ShiroFPV/ShiroFPV_Flight_Controller_Collection/V1_30x30_SFVPF435/Shematic/ShiroFPV_Flight_Controller.kicad_pcb

## KiCad design V1_30x30_SFVPF435/Shematic/ShiroFPV_Flight_Controller.kicad_pcb (2026-06-26)

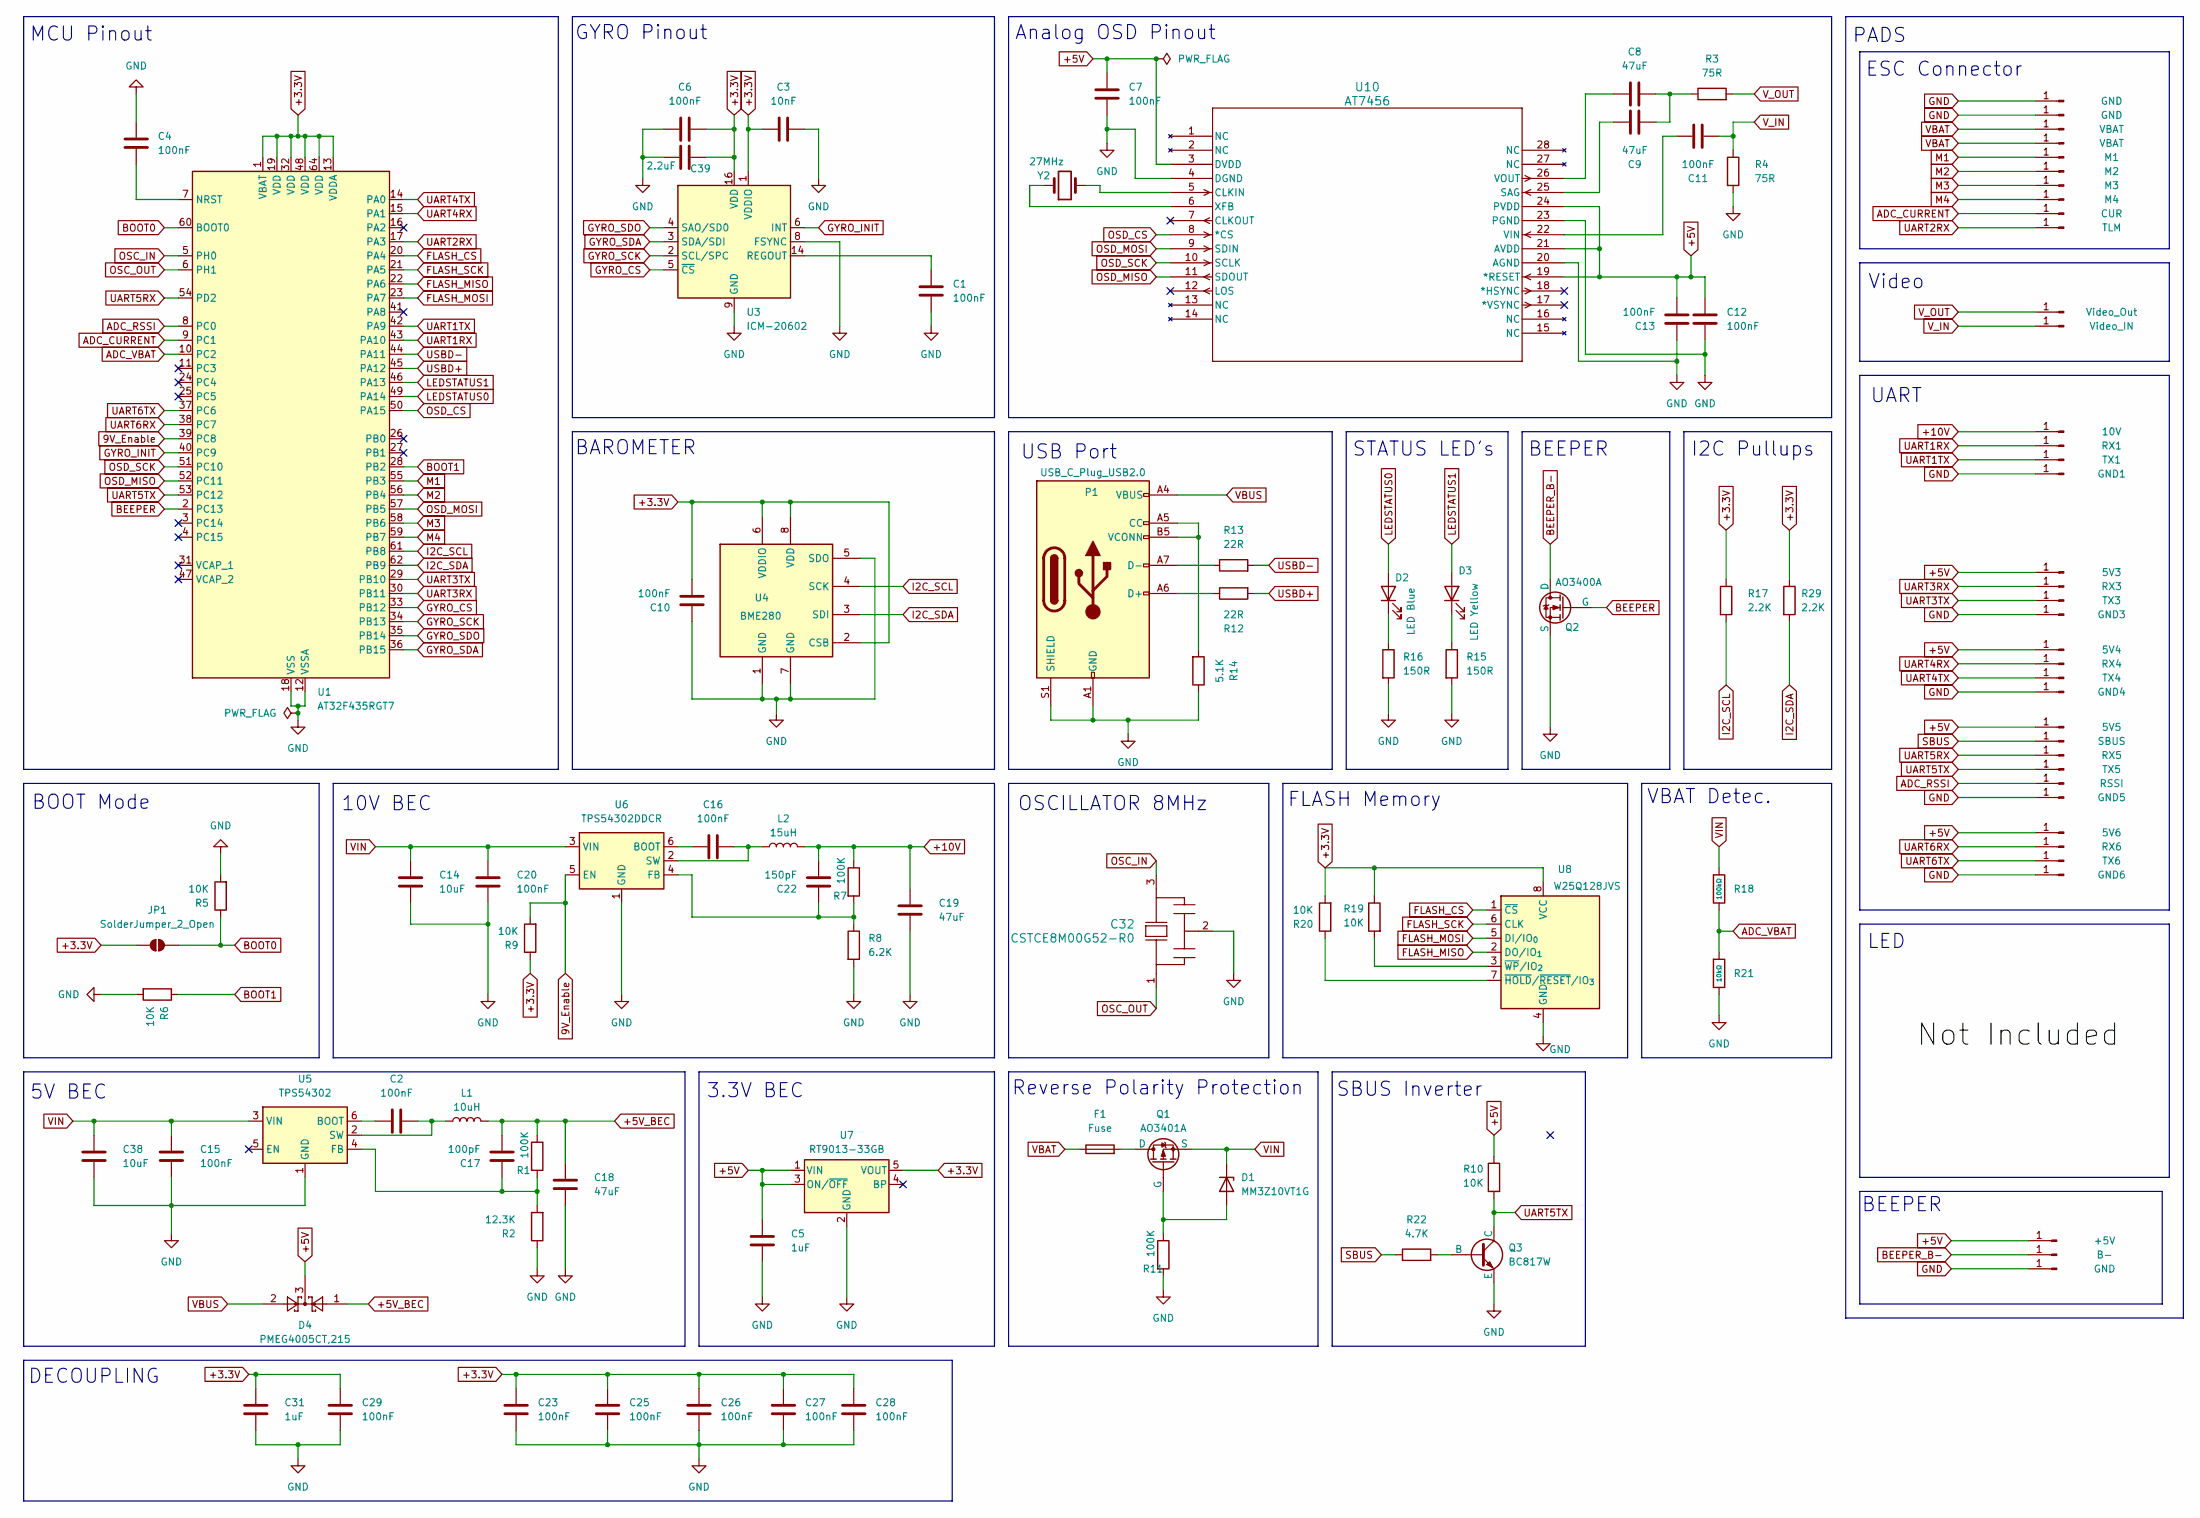
[picture p1: schematic ShiroFPV_Flight_Controller.kicad_sch, AT435 Flight Controller]

Parts:
C1, C2, C4, C6, C7, C10, C11, C12, C13, C15, C16, C20, C23, C25, C26, C27, C28, C29: 100nF; C_0603_1608Metric; MPN CC0603JRX7R8BB104
C3: 10nF; C_0603_1608Metric; MPN C0603C103F3GECAUTO
C5, C31: 1uF; C_0603_1608Metric; MPN 1uF_0603_X7R_16V
C8, C9: 47uF; C_0603_1608Metric; MPN GRM31CR61E476ME44L
C14, C38: 10uF; C_1206_3216Metric; MPN CL31B106KBHNNNE
C17: 100pF; C_0603_1608Metric; MPN CC0603JRX7R9BB101
C18, C19: 47uF; C_1206_3216Metric; MPN GRM31CR61E476ME44L
C22: 150pF; C_0603_1608Metric; MPN CC0603JRX7R9BB151
C32: CSTCE8M00G52-R0; 8MHz-Osciallator.kicad_sym; MPN CSTNE8M00G520000R0
C39: 2.2uF; C_0603_1608Metric; MPN CC0603KRX5R6BB225
D1: MM3Z10VT1G; D_SOD-323_HandSoldering; MPN LM3Z10VT1G
D2: LED Blue; LED_0603_1608Metric
D3: LED Yellow; LED_0603_1608Metric
D4: PMEG4005CT,215; SOT-23
F1: Fuse; Fuse_1206_3216Metric
J1, J2, J46: GND; TestPoint_Pad_1.0x1.0mm
J3, J4: VBAT; TestPoint_Pad_1.0x1.0mm
J5: M1; TestPoint_Pad_1.0x1.0mm
J6: M2; TestPoint_Pad_1.0x1.0mm
J7: M3; TestPoint_Pad_1.0x1.0mm
J8: M4; TestPoint_Pad_1.0x1.0mm
J9: CUR; TestPoint_Pad_1.0x1.0mm
J10: TLM; TestPoint_Pad_1.0x1.0mm
J11: Video_Out; TestPoint_Pad_1.0x1.0mm
J12: Video_IN; TestPoint_Pad_1.0x1.0mm
J13: 5V3; TestPoint_Pad_1.0x1.0mm
J14: RX3; TestPoint_Pad_1.0x1.0mm
J15: TX3; TestPoint_Pad_1.0x1.0mm
J16: GND3; TestPoint_Pad_1.0x1.0mm
J17: 5V4; TestPoint_Pad_1.0x1.0mm
J18: RX4; TestPoint_Pad_1.0x1.0mm
J19: TX4; TestPoint_Pad_1.0x1.0mm
J20: GND4; TestPoint_Pad_1.0x1.0mm
J24: +5V; TestPoint_Pad_1.0x1.0mm
J25: RSSI; TestPoint_Pad_1.0x1.0mm
J26: GND5; TestPoint_Pad_1.0x1.0mm
J29: SBUS; TestPoint_Pad_1.0x1.0mm
J30: 5V5; TestPoint_Pad_1.0x1.0mm
J31: RX5; TestPoint_Pad_1.0x1.0mm
J32: TX5; TestPoint_Pad_1.0x1.0mm
J33: RX6; TestPoint_Pad_1.0x1.0mm
J34: 5V6; TestPoint_Pad_1.0x1.0mm
J35: GND6; TestPoint_Pad_1.0x1.0mm
J36: TX6; TestPoint_Pad_1.0x1.0mm
J37: 10V; TestPoint_Pad_1.0x1.0mm
J38: RX1; TestPoint_Pad_1.0x1.0mm
J39: TX1; TestPoint_Pad_1.0x1.0mm
J40: GND1; TestPoint_Pad_1.0x1.0mm
J42: B-; TestPoint_Pad_1.0x1.0mm
JP1: SolderJumper_2_Open; SolderJumper-2_P1.3mm_Open_Pad1.0x1.5mm
L1: 10uH; L_APV_APH0412
L2: 15uH; L_APV_APH0412; MPN YSPI0530-150M
P1: USB_C_Plug_USB2.0; USB_C_Receptacle_G-Switch_GT-USB-7010ASV; MPN GT-USB-7010ASV
Q1: AO3401A; SOT-23
Q2: AO3400A; SOT-23
Q3: BC817W; SOT-323_SC-70
R1, R7, R11: 100K; R_0603_1608Metric; MPN RC0603FR-07100KL
R2: 12.3K; R_0603_1608Metric; MPN RC0603FR-0712K3L
R3, R4: 75R; R_0603_1608Metric; MPN RC0603FR-0775RL
R5, R6, R9, R10, R19, R20: 10K; R_0603_1608Metric; MPN RC0603FR-0710KL
R8: 6.2K; R_0603_1608Metric; MPN RC0603FR-076K2L
R12, R13: 22R; R_0603_1608Metric; MPN RC0603FR-0722RL
R14: 5.1K; R_0603_1608Metric; MPN RC0603FR-075K1L
R15, R16: 150R; R_0603_1608Metric; MPN RC0603FR-07150RL
R17, R29: 2.2K; R_0603_1608Metric; MPN RC0603FR-072K2L
R18: 100kΩ; R_0603; Overload Voltage (Max) 75V; Tolerance ±1%; Part 0603WAF1003T5E; LCSC C25803
R21: 10kΩ; R_0603; Overload Voltage (Max) 75V; Tolerance ±1%; Part 0603WAF1002T5E; LCSC C25804
R22: 4.7K; R_0603_1608Metric; MPN RC0603FR-074K7L
U1: AT32F435RGT7; LQFP-64_10x10mm_P0.5mm
U3: ICM-20602; LGA-16_3x3mm_P0.5mm_LayoutBorder3x5y; MPN ICM-20602
U4: BME280; Bosch_LGA-8_2.5x2.5mm_P0.65mm_ClockwisePinNumbering; MPN BME280
U5: TPS54302; SOT-23-6; MPN TPS54302DDCR
U6: TPS54302DDCR; SOT-23-6; MPN TPS54302DDCR
U7: RT9013-33GB; SOT-23-5; MPN RT9013-33GB
U8: W25Q128JVS; SOIC-8_5.3x5.3mm_P1.27mm; MPN W25Q128JVSIQ
U10: AT7456; MPN AT7456E
Y2: 27MHz; Crystal_SMD_3225-4Pin_3.2x2.5mm

Connections:
9V_Enable: R9.2, U1.39 (PC8), U6.5 (EN)
+3.3V: C3.1, C6.2, C10.1, C23.1, C25.1, C26.1, C27.1, C28.1, C29.1, C31.1, C39.1, JP1.1 (A), R9.1, R17.1, R19.1, R20.2, R29.1, U1.1 (VBAT), U1.13 (VDDA), U1.19 (VDD), U1.32 (VDD), U1.48 (VDD), U1.64 (VDD), U3.1 (VDDIO), U3.16 (VDD), U4.2 (CSB), U4.6 (VDDIO), U4.8 (VDD), U7.5 (VOUT), U8.8 (VCC)
+5V: C5.1, C7.2, C12.2, C13.1, D4.3, J13.1 (Pin_1_1), J17.1 (Pin_1_1), J24.1 (Pin_1_1), J30.1 (Pin_1_1), J34.1 (Pin_1_1), R10.1, U7.1 (VIN), U7.3 (ON/~OFF), U10.3 (DVDD), U10.19 (*RESET), U10.21 (AVDD), U10.24 (PVDD)
+5V_BEC: C17.1, C18.1, D4.1, L1.2, R1.1
+10V: C19.1, C22.1, J37.1 (Pin_1_1), L2.2, R7.1
ADC_CURRENT: J9.1 (Pin_1_1), U1.9 (PC1)
ADC_RSSI: J25.1 (Pin_1_1), U1.8 (PC0)
ADC_VBAT: R18.2, R21.1, U1.10 (PC2); also elsewhere on the board
BEEPER: Q2.2 (G), U1.2 (PC13)
BEEPER_B-: J42.1 (Pin_1_1), Q2.1 (D)
BOOT0: JP1.2 (B), R5.1, U1.60 (BOOT0)
BOOT1: R6.1, U1.28 (PB2)
FLASH_CS: U1.20 (PA4), U8.1 (~CS)
FLASH_MISO: U1.22 (PA6), U8.2 (DO/IO_{1})
FLASH_MOSI: U1.23 (PA7), U8.5 (DI/IO_{0})
FLASH_SCK: U1.21 (PA5), U8.6 (CLK)
GND: C1.1, C3.2, C4.1, C5.2, C6.1, C7.1, C10.2, C12.1, C13.2, C14.2, C15.2, C18.2, C19.2, C20.2, C23.2, C25.2, C26.2, C27.2, C28.2, C29.2, C31.2, C32.2, C38.2, C39.2, J1.1 (Pin_1_1), J2.1 (Pin_1_1), J16.1 (Pin_1_1), J20.1 (Pin_1_1), J26.1 (Pin_1_1), J35.1 (Pin_1_1), J40.1 (Pin_1_1), J46.1 (Pin_1_1), P1.A1 (GND), P1.A12 (GND), P1.B1 (GND), P1.B12 (GND), P1.S1 (SHIELD), Q2.3 (S), Q3.3 (E), R2.1, R4.2, R5.2, R6.2, R8.2, R11.2, R14.1, R15.2, R16.2, R21.2, U1.12 (VSSA), U1.18 (VSS), U1.63 (VSS), U3.8 (FSYNC), U3.9 (GND), U3.10 (GND), U3.11 (GND), U3.12 (GND), U3.13 (GND), U3.15 (GND), U4.1 (GND), U4.5 (SDO), U4.7 (GND), U5.1 (GND), U6.1 (GND), U7.2 (GND), U8.4 (GND), U10.4 (DGND), U10.20 (AGND), U10.23 (PGND), Y2.3, Y2.4
GYRO_CS: U1.33 (PB12), U3.5 (~CS)
GYRO_INIT: U1.40 (PC9), U3.6 (INT)
GYRO_SCK: U1.34 (PB13), U3.2 (SCL/SPC)
GYRO_SDA: U1.36 (PB15), U3.3 (SDA/SDI)
GYRO_SDO: U1.35 (PB14), U3.4 (SAO/SD0)
I2C_SCL: R17.2, U1.61 (PB8), U4.4 (SCK)
I2C_SDA: R29.2, U1.62 (PB9), U4.3 (SDI)
LEDSTATUS0: D2.2 (A), U1.49 (PA14)
LEDSTATUS1: D3.2 (A), U1.46 (PA13)
M1: J5.1 (Pin_1_1), U1.55 (PB3)
M2: J6.1 (Pin_1_1), U1.56 (PB4)
M3: J7.1 (Pin_1_1), U1.58 (PB6)
M4: J8.1 (Pin_1_1), U1.59 (PB7)
unnamed: C8.2, C9.2, R3.1
unnamed: D1.2 (A), Q1.2 (G), R11.1
unnamed: D2.1 (K), R16.1
unnamed: D3.1 (K), R15.1
unnamed: P1.A5 (CC), P1.B5 (VCONN), R14.2
unnamed: P1.A6 (D+), R12.1
unnamed: P1.A7 (D-), R13.1
unnamed: F1.2, Q1.1 (D)
unnamed: Q3.2 (B), R22.2
unnamed: C4.2, U1.7 (NRST)
unnamed: C1.2, U3.14 (REGOUT)
unnamed: C2.2, U5.6 (BOOT)
unnamed: C17.2, R1.2, R2.2, U5.4 (FB)
unnamed: C2.1, L1.1, U5.2 (SW)
unnamed: C16.2, U6.6 (BOOT)
unnamed: C22.2, R7.2, R8.1, U6.4 (FB)
unnamed: C16.1, L2.1, U6.2 (SW)
unnamed: R20.1, U8.7 (~HOLD/~RESET/IO_{3})
unnamed: R19.2, U8.3 (~WP/IO_{2})
unnamed: U10.5 (CLKIN), Y2.2
unnamed: C9.1, U10.25 (SAG)
unnamed: C11.1, U10.22 (VIN)
unnamed: C8.1, U10.26 (VOUT)
unnamed: U10.6 (XFB), Y2.1
OSC_IN: C32.3, U1.5 (PH0)
OSC_OUT: C32.1, U1.6 (PH1)
OSD_CS: U1.50 (PA15), U10.8 (*CS)
OSD_MISO: U1.52 (PC11), U10.11 (SDOUT)
OSD_MOSI: U1.57 (PB5), U10.9 (SDIN)
OSD_SCK: U1.51 (PC10), U10.10 (SCLK)
SBUS: J29.1 (Pin_1_1), R22.1
UART1RX: J38.1 (Pin_1_1), U1.43 (PA10)
UART1TX: J39.1 (Pin_1_1), U1.42 (PA9)
UART2RX: J10.1 (Pin_1_1), U1.17 (PA3)
UART3RX: J14.1 (Pin_1_1), U1.30 (PB11)
UART3TX: J15.1 (Pin_1_1), U1.29 (PB10)
UART4RX: J18.1 (Pin_1_1), U1.15 (PA1)
UART4TX: J19.1 (Pin_1_1), U1.14 (PA0)
UART5RX: J31.1 (Pin_1_1), U1.54 (PD2)
UART5TX: J32.1 (Pin_1_1), Q3.1 (C), R10.2, U1.53 (PC12)
UART6RX: J33.1 (Pin_1_1), U1.38 (PC7)
UART6TX: J36.1 (Pin_1_1), U1.37 (PC6)
USBD+: R12.2, U1.45 (PA12)
USBD-: R13.2, U1.44 (PA11)
VBAT: F1.1, J3.1 (Pin_1_1), J4.1 (Pin_1_1)
VBUS: D4.2, P1.A4 (VBUS), P1.A9 (VBUS), P1.B4 (VBUS), P1.B9 (VBUS)
VIN: C14.1, C15.1, C20.1, C38.1, D1.1 (K), Q1.3 (S), R18.1, U5.3 (VIN), U6.3 (VIN); also elsewhere on the board
V_IN: C11.2, J12.1 (Pin_1_1), R4.1
V_OUT: J11.1 (Pin_1_1), R3.2

Notes on the sheet:
DECOUPLING
ESC Connector
OSCILLATOR 8MHz
LED
5V BEC
VBAT Detec.
UART
FLASH Memory
PADS
BAROMETER
BEEPER
Video
STATUS LED's
I2C Pullups
BEEPER
BOOT Mode
MCU Pinout
Analog OSD Pinout
10V BEC
GYRO Pinout
3.3V BEC
USB Port
Reverse Polarity Protection
SBUS Inverter

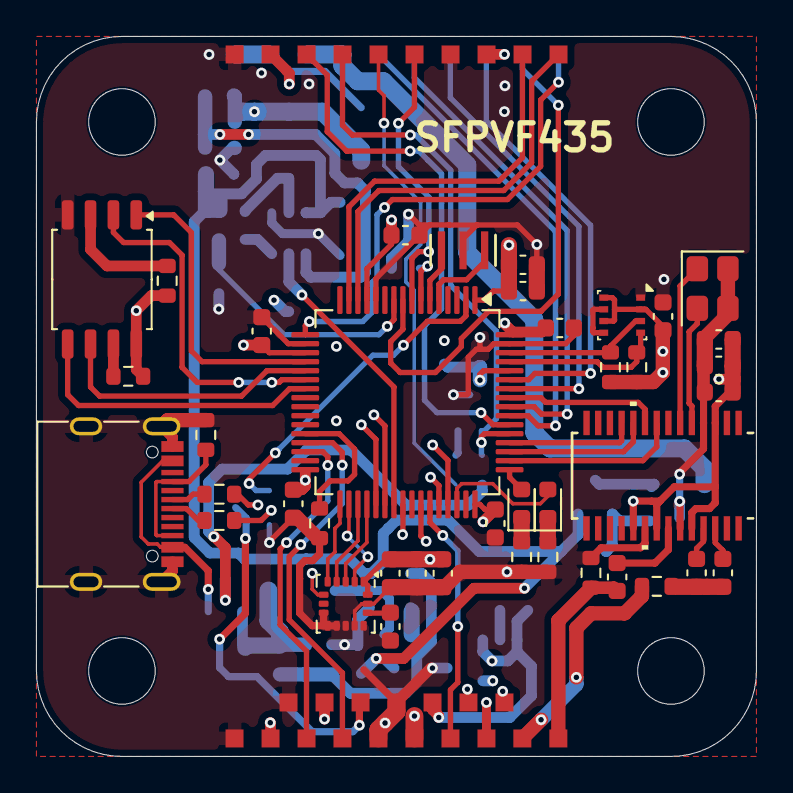
[picture p2: board ShiroFPV_Flight_Controller.kicad_pcb from above]

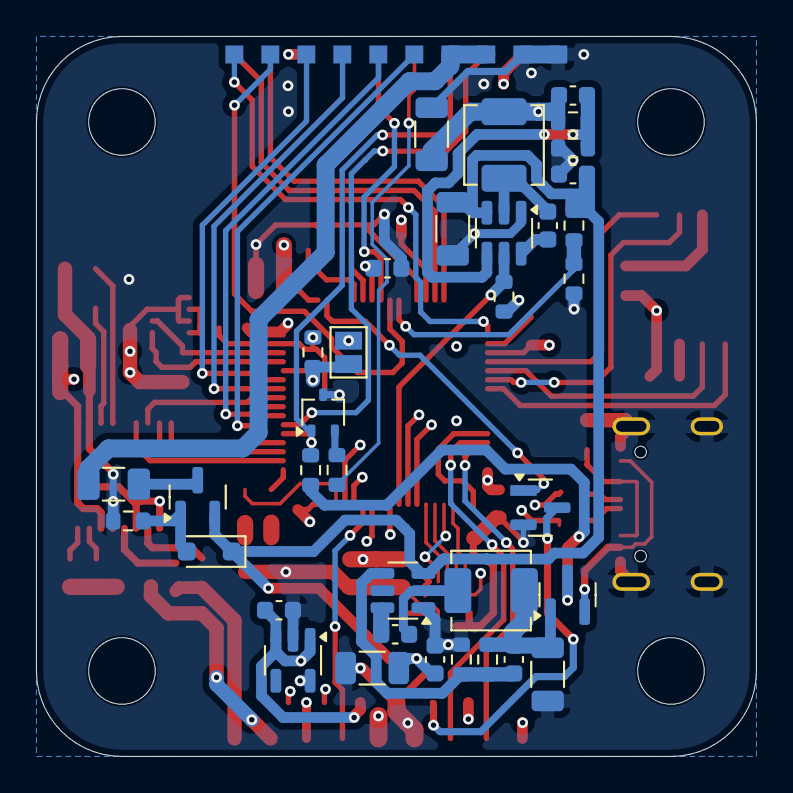
[picture p3: board ShiroFPV_Flight_Controller.kicad_pcb from below]

Board: 4 copper layers, 40.0 x 40.0 mm, 112 parts (45 on the bottom side), 79 nets.

Other parts of the board:
R27: 18K; R_0603_1608Metric

Their connections:
ADC_VBAT: R27.2; also elsewhere on the board
VIN: R27.1; also elsewhere on the board
