ShiroFPV/ShiroFPV_Flight_Controller_Collection/(commit log)

2026-06-26 Add KiCad project files and 3D model
    Add initial project artifacts for V1_30x30_SFVPF435: include a .glb 3D model, a .kicad_prl project preferences file, and KiCad lock files. Also add macOS .DS_Store files. Tweak the board file (ShiroFPV_Flight_Controller.kicad_pcb) by removing a stray "zone_defaults" entry.
    [ShiroFPV_Flight_Controller.kicad_pcb]
2026-09-24 Update dimensions for V2 SFVPF435 board
